CMU-Robotics-Club/Tooltron/boards/ToolTron_ToolBoxv2.0.brd

## EAGLE design boards/ToolTron_ToolBoxv2.0.brd (2013-01-27)

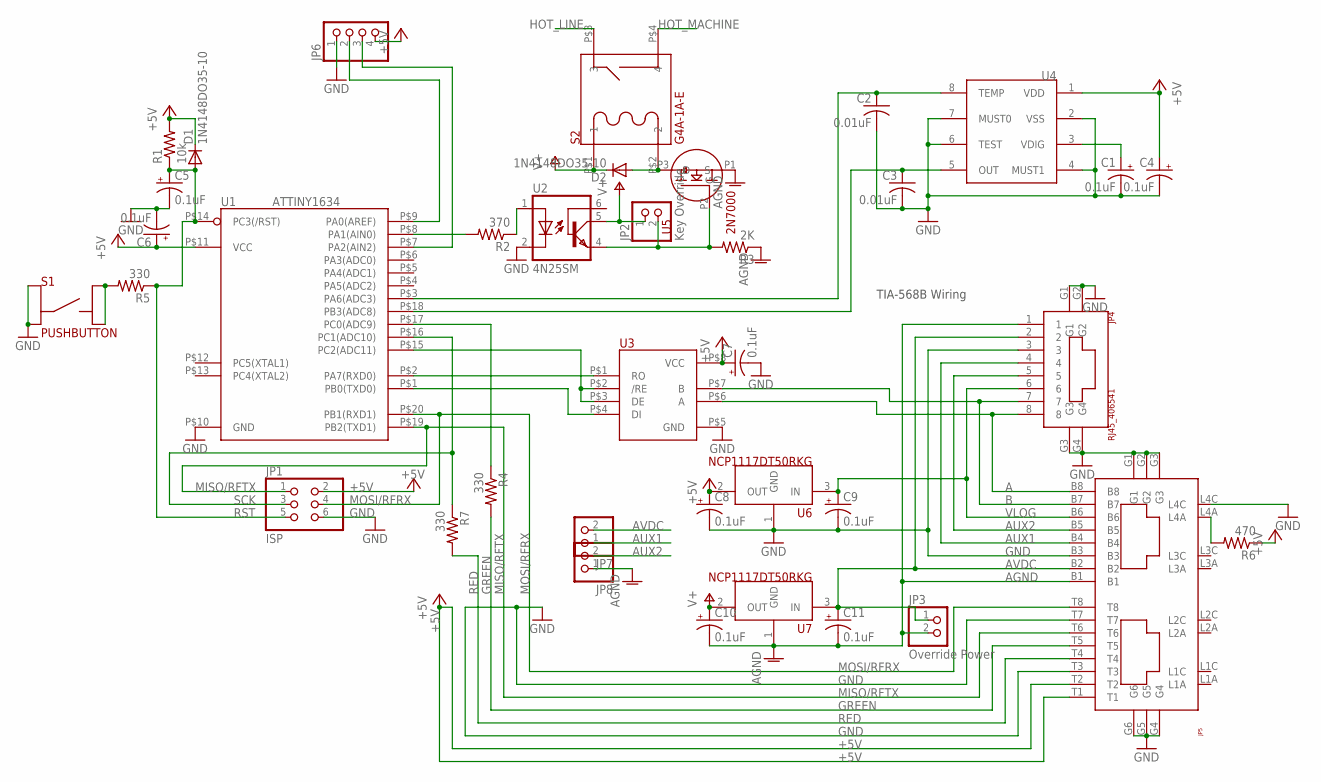
[picture p1: schematic ToolTron_ToolBoxv2.0.sch]

Parts:
C1, C4, C10, C11: 0.1uF; UD-4X5,8_NICHICON
C2, C3: 0.01uF; C0805
C5, C6, C7, C8, C9: 0.1uF; E2-5
D1, D2: 1N4148DO35-10; DO35-10
JP1: ISP; 2X03
JP2: Key Override; 1X02_OVAL
JP3: Override Power; 1X02_OVAL
JP4: RJ45_406541; 1-406541-1
JP5: 2XRJ45_RJSAE538X02X; RJSAE538X02X
JP6: HEADER-1X4ROUND; 1X04_ROUND
JP7, JP8: HEADER-1X2ROUND; 1X02_ROUND
R1: 10k; 0207/10
R2: 370; 0207/10
R3: 2K; 0207/10
R4, R5, R7: 330; 0207/10
R6: 470; 0207/10
S1: PUSHBUTTON; FSM4JH
S2: G4A-1A-E
U1: ATTINY1634; SOIC-20
U2: 4N25SM; DIL6-SMD; MPN 4N25SM
U3: MAX13082E; SOIC-8
U4: MLX91206; SOIC-8
U5: 2N7000; TO-92
U6, U7: NCP1117DT50RKG; DPAK

Connections:
+5V: C4.+, C6.+, C7.+, C8.+, D1.C, JP1.2, JP5.T1, JP5.T2, JP6.4, R1.2, R6.1, U1.P$11 (VCC), U3.P$8 (VCC), U4.1 (VDD), U6.2 (OUT)
A: JP4.8, JP5.B8, U3.P$6 (A)
AGND: C10.-, C11.-, JP3.2, JP4.1, JP5.B1, JP8.1, R3.1, U5.P1 (S), U7.1 (GND)
AUX1: JP4.4, JP5.B4, JP7.1
AUX2: JP4.5, JP5.B5, JP8.2
AVDC: C11.+, JP3.1, JP4.2, JP5.B2, JP7.2, U7.3 (IN)
B: JP4.7, JP5.B7, U3.P$7 (B)
DI: U1.P$1 (PB0(TXD0)), U3.P$4 (DI)
EN: U1.P$15 (PC2(ADC11)), U3.P$2 (/RE), U3.P$3 (DE)
GND: C1.-, C2.2, C3.2, C4.-, C5.-, C6.-, C7.-, C8.-, C9.-, JP1.6, JP4.3, JP4.G1, JP4.G2, JP4.G3, JP4.G4, JP5.B3, JP5.G1, JP5.G2, JP5.G3, JP5.G4, JP5.G5, JP5.G6, JP5.L4C, JP5.T3, JP5.T7, JP6.1, S1.1, S1.2, U1.P$10 (GND), U2.2 (C), U3.P$5 (GND), U4.2 (VSS), U4.4 (MUST1), U4.6 (TEST), U4.7 (MUST0), U6.1 (GND)
GREEN: JP5.T5, R4.2
HOT_LINE: S2.P$3 (3)
HOT_MACHINE: S2.P$4 (4)
MISO/RFTX: JP1.1, JP5.T6, U1.P$19 (PB2(TXD1))
MOSI/RFRX: JP1.4, JP5.T8, U1.P$20 (PB1(RXD1))
unnamed: D2.A, S2.P$2 (2), U5.P3 (D)
unnamed: R5.2, S1.3, S1.4
unnamed: C3.1, U1.P$18 (PB3(ADC8)), U4.5 (OUT)
unnamed: C1.+, U4.3 (VDIG)
unnamed: C2.1, U1.P$3 (PA6(ADC3)), U4.8 (TEMP)
unnamed: R2.2, U1.P$8 (PA1(AIN0))
unnamed: R2.1, U2.1 (A)
unnamed: JP2.2, R3.2, U2.4 (EMI), U5.P2 (G)
unnamed: JP5.L4A, R6.2
unnamed: R4.1, U1.P$17 (PC0(ADC9))
PA0: JP6.2, U1.P$9 (PA0(AREF))
PA2: JP6.3, U1.P$7 (PA2(AIN2))
RED: JP5.T4, R7.2
RO: U1.P$2 (PA7(RXD0)), U3.P$1 (RO)
RST: C5.+, D1.A, JP1.5, R1.1, R5.1, U1.P$14 (PC3(/RST))
SCK: JP1.3, R7.1, U1.P$16 (PC1(ADC10))
V+: C10.+, D2.C, JP2.1, S2.P$1 (1), U2.5 (COL), U7.2 (OUT)
VLOG: C9.+, JP4.6, JP5.B6, U6.3 (IN)

Notes on the sheet:
TIA-568B Wiring

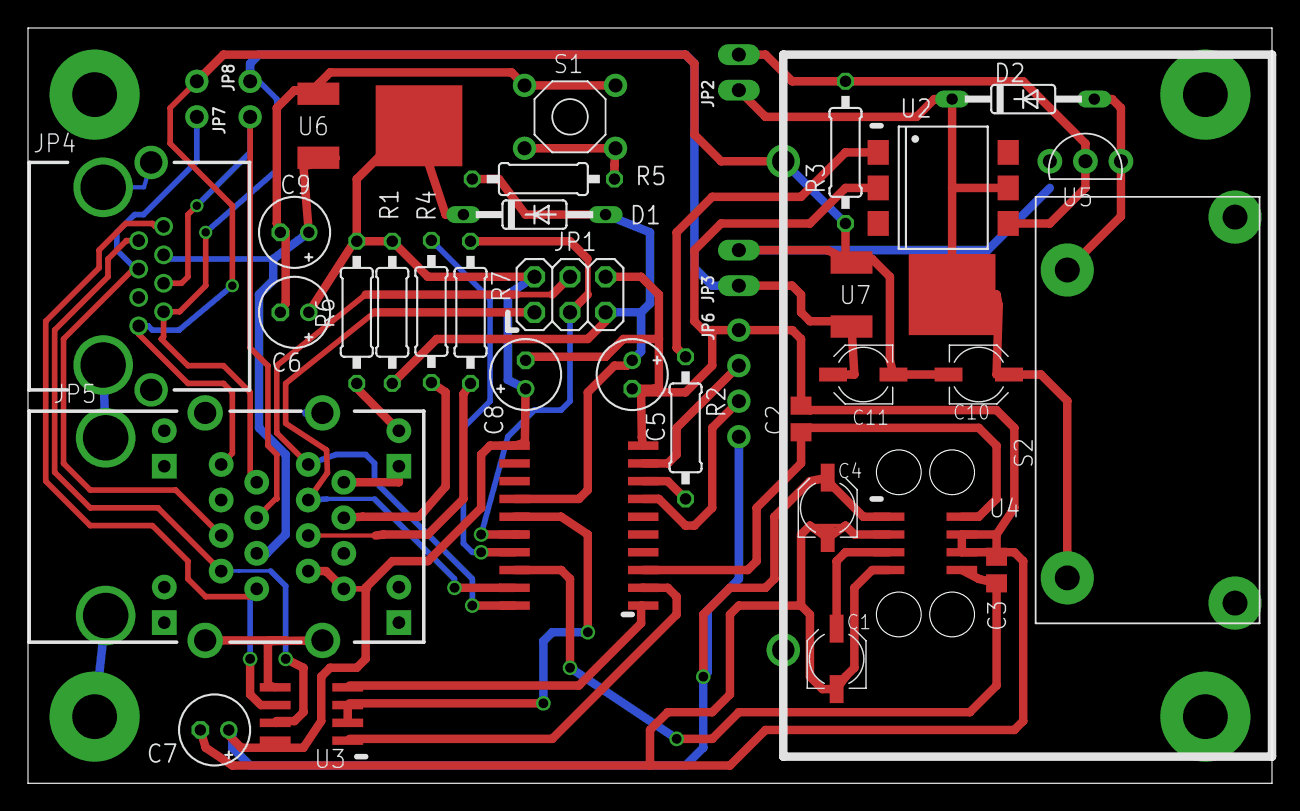
[picture p2: board ToolTron_ToolBoxv2.0.brd from above]

Board: 2 copper layers, 88.9 x 54.0 mm, 37 parts (0 on the bottom side), 31 nets.
