CMU-Robotics-Club/Tooltron/toolbox/current.c

#include "current.h"
#include <avr/io.h>
#include <avr/interrupt.h>
#include <math.h>

// TODO the ADC is run once every 2ms no matter what these numbers
// say. They're not used. Actual samples/cycle is around 8.3
#define CYCLES_PER_SECOND 60 // wall power
#define SAMPLES_PER_CYCLE  8
#define N_SAMPLES 24

unsigned int samples[N_SAMPLES];
int sample_idx;

unsigned int sum;
unsigned long sum_sq;

void current_init() {

  /* TODO reduce power consumption with DIDR* */

  /*
   * REFS = 0, Vcc reference (set to 2 for internal 1.1V reference)
   * MUX = 8, PB3(ADC8)
   */
  ADMUX = _BV(MUX3);

  /*
   * ADLAR = 0, right adjust result
   */
  ADCSRB = 0;

  /*
   * ADEN = 1, enable
   * ADSC = 0, don't start yet
   * ADATE = 0, no auto trigger
   * ADIE = 1, enable interrupt
   * ADPS = 6, prescale clock by 64
   */
  ADCSRA = _BV(ADEN) | _BV(ADIE) | _BV(ADPS2) | _BV(ADPS1);
}

void current_start_adc() {
  ADCSRA |= _BV(ADSC);
}

ISR(ADC_vect) {
  unsigned int old, new;

  new = ADC;

  /* put sample into ring buffer */
  old = samples[sample_idx];
  samples[sample_idx++] = new;
  if (sample_idx == N_SAMPLES)
    sample_idx = 0;

  /* keep a running total of samples and samples squared */
  sum += new;
  sum -= old;
  sum_sq += (unsigned long)new*new;
  sum_sq -= (unsigned long)old*old;
}

unsigned int current_read() {
  unsigned int _sum;
  unsigned long _sum_sq;

  cli();
  _sum = sum;
  _sum_sq = sum_sq;
  sei();

  /* calculate the variance using sum and sum_sq */
  return (N_SAMPLES*_sum_sq - (unsigned long)_sum*_sum) /
    (N_SAMPLES*(N_SAMPLES-1));
}
