CMU-Robotics-Club/Tooltron/(commit log)

2012-11-18 Fixed problem with high error in serial clock
    [port.h, portserial.c]
2012-11-18 Removed superfluous printf in rfid read script
2012-11-18 Fixed U2X1 being set in the wrong control register
    [serial.c]
2012-11-18 Various fixes to tool main.c
    - Input register callback no longer copies current_user to reg_buf
    prematurely, and then write the uninitialized serno into reg_buf (?!)
    - tool_disable was missing a ~
    - Updated coil read/write to use new 1 indexed addresses
    [main.c]
2012-11-18 Added printing the response timeout, and other fixes
    - Fixed using SLAVE_ADDR instead of tool->address
    - Replaced read_registers with read_input_registers
    [tool.c]
2012-11-21 Added LED header, and some rfid debugging
2012-11-27 Revert "Removed superfluous printf in rfid read script"
    This reverts commit e66d0e5c23eaaf3db53409d05beb0e1fcdbe1610.
2012-11-28 Fixed compile errors; finished converting char -> uint8_t
    [rfid.h, serial.h]
2012-11-29 Added LED blinking, and other fixes
    [led.c, led.h, main.c, tool.c]
2012-12-01 Fixes. It tooltrons at a basic level now.
    [led.c, main.c, rfid.c, tool.c]
2012-12-02 Made rfid.c more robust against false negatives
    Also changed LED code to be more generally usable, and changed mainbox
    to grant access to a particular user id instead of randomly choosing
2012-12-03 Fixed timer error correction
    [led.c]
2012-12-03 Added tool state TS_DENY, with red LED until card is removed
2012-12-11 Added current sensing to toolbox
2012-12-12 initial commit of tooltron boards
    [ToolTron_RFIDBoxv2.0.sch, ToolTron_ToolBoxv2.0.brd, ToolTron_ToolBoxv2.0.sch]
2012-12-13 Added flushing before write to rfid reader
    And other various fixes and changes, which I don't remember. Changed
    rfid reading to read every tick, but only try writing if enough ticks
    have passed.
    [main.c, rfid.c, rfid.h, time.c]
2013-01-04 fixed a couple errors in the models.py. Then preformed a migration.
2013-01-21 Added getopt for inputting serial device and CRM server
2013-01-27 updated boards to include holes.
    [ToolTron_ToolBoxv2.0.brd, ToolTron_ToolBoxv2.0.sch]
2013-01-28 Made errors less noisy
    If it can't connect to a tool, it will print an error once, and then
    print another message when it is able to reconnect.
    [main.c, tool.c, tool.h]
2013-01-30 mainbox now prints error on 404 or 500 from server
    [query.c, tool.c]
2013-02-03 Fixed annoying warnings about avr/signal.h
    [portserial.c, porttimer.c]
2013-02-10 Untested current RMS calculation
    It's not actually RMS, it's variance. Same general idea.
2013-02-10 Switch ADC to timer 1 because timer 0 was taken. Oops.
2013-02-18 Fixed overflow in current calculation
    [current.c]
2013-02-28 Fixed timing in current sensing
    The ADC interrupt didn't clear the TIFR timer interrupt flag, which
    means the ADC wasn't triggered again on the next compare match.
    [current.c]
2013-03-01 Fixed another overflow bug and removed isqrt
    [current.c]
2013-03-20 Fixed curl SSL queries failing and queue bug
    [event.c, event.h, query.c]
2013-04-14 Adding rfid-web
    The javascript will query the rfid reader (using main.c, set up on
    tooltron.roboclub.org with CGI) and insert it into a form.
2013-05-13 Major changes to mainbox code.
    -Added local cache for RFID -> tool permissions
    -Queries new page /crm/roboauth/%08x, which gives bitmask of all tool
    permissions instead of just one
    -Added pid file at /var/run/tooltron.pid
    -Now must be run as "tooltron run" and also has "tooltron refresh" and
    "tooltron clear" which send signals to the pid in the pid file
    -Other things I'm forgetting
2013-06-09 Added stop command and fixed pid file deletion
    [main.c, util.c, util.h]
2013-10-06 Fixed build warnings from last commit
    [query.c, util.c]
2014-02-13 Implemented code for new RFID readers
    It's not fully working yet. When the checksum is enabled, it ignores all
    responses. Also, it no longer recognizes a missing card.
    [rfid.c, serial.h]
2014-02-13 Fixed event queue bug
    [event.c]
2014-02-13 Removed pid file necessity
    Still uses it if running as root, but otherwise doesn't bother. Should
    be a bit easier for local testing.
    [main.c]
2014-02-13 Fixed card removal detection
    Also switched from using seek command to select command with the reader.
    Select returns a result immediately, rather than seek which first
    returns an "in progress" error then later returns the card (as far as I
    can tell).
    [rfid.c]
2014-04-20 Fixed a few issues setting up tooltron on Marvin
    [log.c]
2014-10-18 Added shutoff when current is sensed when enabling tool
    Also made a number of fixes to current sensing, which was quite broken.
    [current.c, main.c, time.c]
2015-03-15 Fixed URL construction with tool_id bug.
    [query.c]
2015-03-15 Use cache on network failure. Update on every successful server request.
    [cache.c, cache.h, query.c, tool.c]
2015-04-03 Tool 'powered' field support.
